tactical-snacks/hum_fw/docs/hum_hw.pdf

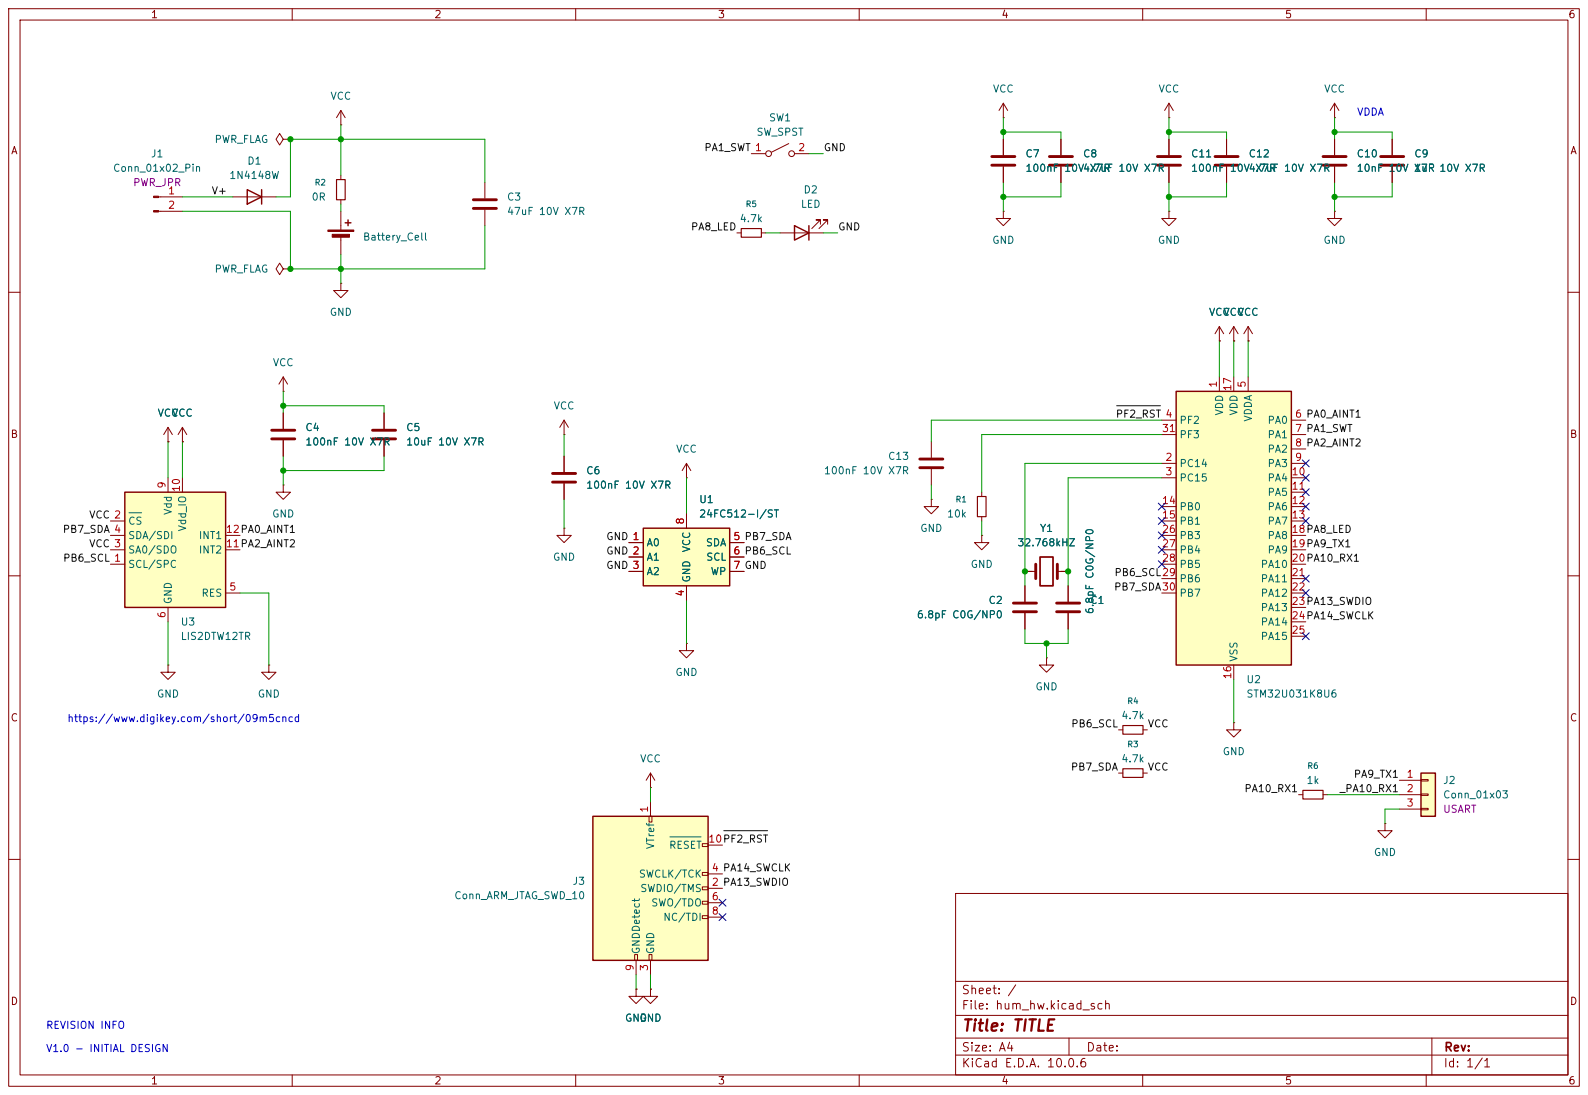
[picture p1: page 1]

https://www.digikey.com/short/09m5cncd

Size: A4 | Rev:
KiCad E.D.A. 10.0.6 | Id: 1/1
