tactical-snacks/hum_fw/(commit log)

2026-10-16 pin assignments, ini
2026-10-19 clock config: MSI 16 MHz trimmed by LSE
    SystemClock_Config() replaces the variant's empty stub: MSI 16 MHz,
    voltage range 2, 1 WS, LSE crystal on at medium-low drive, MSI PLL
    mode. F_CPU set to 16 MHz in platformio.ini and the board file.
    README dev list adds the hello world step.
2026-10-31 accel INT1/INT2 test, LSE fallback, bench tools
    - route DRDY (pulsed) to INT1/INT2, count edges on PA0/PA2, print rate
    - startup pin check: flip H_LACTIVE with pull-ups on to detect open/shorted INT lines
    - if LSE fails to start, run MSI untrimmed instead of hanging in Error_Handler
    - tools/serial_capture.py and tools/lse_drive_timing.tcl for bench testing
    - allow pio, openocd, and serial capture commands in project Claude settings
2026-10-31 eeprom bring-up: boot counter; drop INT1/INT2 test
    - 24FC512 read, page-bounded write, ACK-poll ready wait
    - boot counter at 0x0000, incremented and verified each boot
    - remove INT1/INT2 pin check, DRDY routing, and edge counting
    - boot prints lse / acc / eep status and boot count
2026-11-01 free-fall LED and EEPROM counter, button status print, VCC reading
    - LED follows accel free-fall on INT1 (312 mg, 2 samples); blinking removed
    - falls over 1 s counted in EEPROM at 0x0004, total printed at startup
    - button on PA1 (pull-up, 30 ms debounce) prints accel, fall count, VCC
    - VCC from VREFINT with factory calibration, also printed at startup
    - remove periodic accel prints and loop delay
2026-11-01 RTC on LSE, set over UART; timestamp on button print; bench tools doc
    - RTC clocked from LSE at 1 Hz; init skipped once set so resets don't lose time
    - T<YYYYMMDD-HH:MM:SS> on UART RX sets the clock; tools/set_rtc.py sends PC time
    - button print starts with YYYYMMDD-HH:MM:SS
    - LED blips 5 ms every second while the clock is unset (free-fall takes priority)
    - tools/tools.md documents the bench scripts and J2 wiring; linked from README
2026-11-01 sleep in Stop 2, wake on motion or button; serial settings from platformio.ini
    - MCU in Stop 2 after a 5 s awake window; wakes on accel INT1 (PA0) or button (PA1)
    - on wake: LED flash and status line (time, source, accel, vcc); no sleep while RTC unset
    - accel: low-power mode 1 at 12.5 Hz, latched wake-up at 62.5 mg; wait for INT1 to
    drop after clearing (it lags up to one sample) to avoid false wakes
    - remove free-fall LED/counter and falls from the status print
    - uploads connect under reset (SWD is off in Stop 2)
    - monitor_speed in platformio.ini, monitor_port in gitignored platformio_local.ini;
    set_rtc.py and serial_capture.py read both via PlatformIO's config
    - tools.md and README upd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
2026-11-01 status line: temperature from accel, "wake btn" for awake presses
    - read LIS2DTW12 die temperature (12-bit, 16 LSB/C) and print in tenths of a degree
    - button press while awake now prints "wake btn", same as a press that wakes
    - README: size table refreshed, temperature added to changelog
2026-11-02 updated brackets
2026-11-02 updated brackets again
2026-11-02 frequency brackets over UART and LED; button-only wake
    Goertzel over 31.25-150 Hz on all three axes from the accel FIFO at 800 Hz,
    +/-8 g. Off below 50 mg rms, otherwise idle or operating by the stronger band.
    hum: line per 0.64 s frame and 1/2/3 LED blips. Awake 10 s per wake; motion
    wake kept behind ACC_WAKE_EN, off, so the accel powers down while asleep.
2026-11-06 amplitude gate and 2-frame confirmation; ERASE command; state machine doc
    - bracket needs the winning band's rms over a sloped gate (700 mg at 30 Hz
    to 200 mg at 100 Hz); changes after 2 agreeing frames; first frame of a
    wake shows what it sensed
    - bracket detection behind HUM_EN, off: button press prints status only
    - ERASE over UART erases the EEPROM after a button press to accept
    - EEPROM map: idle and operating duration totals at 0x0004 / 0x0008
    - state machine moved from freq doc to docs/state_machine.md; freq doc
    states table and detection notes match the brackets
2026-11-06 unit number in EEPROM; rapid flash while clock unset, 1 blip for off
    - EEPROM map shifted: unit number 0x0000, boot count 0x0004, idle and
    operating totals 0x0008 / 0x000C
    - U<number> over UART sets the unit number; printed at boot and in the
    status line
    - LED: rapid 100 ms on/off while the clock is unset; while awake, state
    blips (1 off, 2 idle, 3 operating), 1 blip per second with detection off
    - unknown commands reply "bad command"
2026-11-06 compact status line; boot line shows git revision
    - status line: time, unit, temperature, supply, idle/operating minutes
    (20261105-21:50:40 u2 23.7C 2704mV id0m op0m); accel x/y/z dropped
    - boot prints a blank line, then hum_fw <git describe> from the new
    tools/git_rev.py pre-build script
2026-11-06 state machine: light/deep sleep by state, durations stored in EEPROM
    - every wake samples until 2 readings agree (max 5); undecided keeps state
    - idle/operating: light sleep, RTC wake-up timer every 60 s, accel off
    - off: deep sleep, button or accel motion wake (ACC_WAKE_EN back on)
    - leaving idle/operating adds its seconds to the EEPROM total; each
    transition prints a line; status totals include the session in progress
    - clear the stale motion flag before Stop 2: the step from capture to
    motion mode latched a wake event, so every sleep ended at once
    - state_machine.md: sampling and durations sections
2026-11-06 DBG lines for samples, sleeps and wakes (DBG_EN, on for field testing)
2026-11-07 keep flash powered in Stop 2: RTC timer wake HardFaulted
    With FPD_STOP at its reset default the flash is powered down in Stop 2,
    and a wake by the RTC wake-up timer HardFaulted on the first instruction
    fetch after WFI (stacked PC just past the wfi in HAL_PWREx_EnterSTOP2Mode).
    Button and motion wakes were unaffected. In the field this hung unit 2 on
    its first light-sleep timer wake: nothing stored, button dead until the
    battery was pulled.
    Bench: timer wakes every 10 s ran clean with the fix, faulted on the
    first wake without it. Stop 2 current with flash on not yet measured.
2026-11-07 DBG_EN test timescale: 5 s light sleep, status totals in seconds
    - SM_LIGHT_SLEEP_S is 5 s with DBG_EN, 60 s without
    - status line tagged DBG with totals in seconds under DBG_EN
    - "sampled" DBG line drops the frame count
    - README and state_machine.md note the DBG_EN timescale
2026-11-10 README: dev checklist, bracket time done, sessions with timestamps next
2026-11-13 RTC calibration (C<ppm>), send.py
    C<ppm> stores the measured crystal drift in the EEPROM and corrects it
    with the RTC's smooth calibration, reapplied at boot. send.py sends one
    command and prints the reply. README: Unreleased changelog and size.
2026-11-13 Power budget doc
    Conservative estimate (datasheet max at 55 C, 150 mAh usable): sleep
    floors, awake current, charge per wake, life by running hours/day, and
    traps that drain a cell in days (clock unset, DBG_EN, vibration while off).
